ctolleson/OpenNeurostimulatorCMT/Examples/IPG PCBA/IPG-V1 BOM.xlsx

Quantity | Designator | Description | Manufacturer | Manufacturer Part Number
8 | C100, C101, C104, C105, C210, C211, C215, C219 | Ceramic Capacitor, Multilayer, Ceramic, 25V, 5% +Tol, 5% -Tol, C0G, 30ppm/Cel TC, 0.000012uF, Surface Mount, 0201 | Murata | GRM0335C1E120JA01D
15 | C102, C103, C115, C118, C119, C213, C306, C317, C319, C501, C503, C504, C600, C1201, C1203 | Capacitor, 4.7uF, X5R, 16V, 10%, 0603, Implant-grade | Murata | GRM188R61C475KE11
49 | C106, C107, C108, C109, C110, C111, C112, C113, C114, C116, C120, C214, C216, C307, C500, C502, C507, C508, C509, C510, C511, C512, C602, C700, C701, C702, C703, C704, C800, C801, C807, C808, C815, C816, C819, C820, C821, C822, C901, C903, C905, C908, C1101, C1200, C1202, C1204, C1207, C1300, C1301 | Ceramic Capacitor, Multilayer, Ceramic, 25V, 10% +Tol, 10% -Tol, X5R, 15% TC, 0.1uF, Surface Mount, 0201 | Murata | GRM033R61E104KE14J
7 | C117, C218, C400, C420, C1102, C1205, C1206 | Ceramic Capacitor, Multilayer, Ceramic, 16V, 20% +Tol, 20% -Tol, X5R, 15% TC, 1uF, Surface Mount, 0201 | Murata | GRM033R61C105ME15D
1 | C200 | Capacitor, 0.8pF, Silicon RF, 200V, Tolerance 0.05pF, 0402, Implant-grade | Kyocera AVX | 600L0R8AT200T
1 | C201 | Capacitor, 1pF, RF Capacitors, 200V, Tolerance 0.01pF, 0402, Implant-grade | Kyocera AVX | 600L1R0AT200T
1 | C217 | Ceramic Capacitor, Multilayer, Ceramic, 25V, 10% +Tol, 10% -Tol, X7R, 15% TC, 0.0001uF, Surface Mount, 0201 | Murata | GRM033R71E101KA01D
2 | C300, C301 | Capacitor, 27nF, C0G, 100VDC, 2%, 0805, Implant-grade | Murata | GRM2195C2A273GE01D
2 | C302, C303 | Capacitor, 4.7nF, C0G, 25V, 1%, 0603, Implant-grade | KEMET | C0603C472F3GECTU
1 | C304 | Ceramic Capacitor, Multilayer, Ceramic, 25V, 5% +Tol, 5% -Tol, C0G, 30ppm/Cel TC, 0.000033uF, Surface Mount, 0201 | Murata | GRM0335C1E330JA01D
5 | C310, C311, C318, C505, C506 | Capacitor, 4.7uF, X7S, 35V, 10%, 0805, Implant-grade | Murata | GCM21BC7YA475KE36L
2 | C315, C316 | Capacitor, 0.022uF, X7R, 50V, 10%, 0402, Implant-grade | Murata | GCM155R71H223KA55
2 | C417, C422 | Capacitor, 0.1uF, X7R, 16V, 10%, 0402, Implant-grade | Murata | GCM155R71C104KA55
2 | C419, C423 | Ceramic Capacitor, Multilayer, Ceramic, 25V, 10% +Tol, 10% -Tol, X7R, 15% TC, 0.00047uF, Surface Mount, 0201 | Murata | GCM033R71E471KA03D
1 | C601 | Capacitor, 10uf, X5R, 10V, 20%, 0402, Implant-grade | Murata | ZRB15XR61A106ME01D
2 | C802, C804 | Capacitor, 0.33uF, X7S, 16V, 10%, 0402 | TDK | CGA2B1X7S1C334K050BC
5 | C803, C805, C810, C814, C823 | Ceramic Capacitor, Multilayer, Ceramic, 25V, 10% +Tol, 10% -Tol, X7R, 15% TC, 0.001uF, Surface Mount, 0201 | Murata | GRM033R71E102KA01J
1 | C806 | Capacitor, 1500pF, X7R, 50V, 10%, 0402 | Murata | GCM155R71H152KA37D
2 | C809, C827 | Ceramic Capacitor, Multilayer, Ceramic, 6.3V, 20% +Tol, 20% -Tol, X5R, 15% TC, 1.5uF, Surface Mount, 0201 | Murata | GRM033R60J155ME14D
4 | C811, C812, C824, C825 | Capacitor, 470nF, X5R, 6.3V, 10%, 0201, Implant Grade | Murata | GRT033R60J474KE01D
2 | C813, C828 | 68 pF ±5% 50V Ceramic Capacitor C0G, NP0 0201 (0603 Metric) | Murata Electronics | GRM0335C1H680JA01D
2 | C817, C818 | Capacitor, 2.2uF, X7R, 16V, 10%, 0603, Implant-grade | Murata | GRM188Z71C225ME43J
2 | C826, C829 | 270 pF ±5% 25V Ceramic Capacitor C0G, NP0 0201 (0603 Metric) | Murata Electronics | GRM0335C1E271JA01D
9 | C900, C902, C904, C906, C907, C909, C910, C911, C912 | Capacitor, 10uF, X5R, 50V, 10%, 0805 | Murata | GRM21BR61H106ME43L
16 | C1000, C1001, C1002, C1003, C1004, C1005, C1006, C1007, C1008, C1009, C1010, C1011, C1012, C1013, C1014, C1015 | Capacitor, 680pF, C0G, 100V, 5%, 0402 | TDK | C1005C0G2A681J050BE
1 | C1016 | Capacitor, 68pF, C0G, 25V, 5%, 0201, Implant-grade | Murata | GRT0335C1E680JA02D
10 | D300, D301, D305, D306, D400, D420, D502, D503, D505, D506 | Schottky, 40V, 500mA, 530mV, SOD-523 | ON Semiconductor | NSR05T40XV2T5G
1 | D307 | Zener Diode 10 V 300 mW ±2% Surface Mount DFN1006-2A 0402 | Vishay | BZX884B10L-G3-08
7 | D419, D421, D422, D423, D424, D600, D601 | Schottky, 30V, 100mA, 385mV, 200mW, SOD-923 | ON Semiconductor | NSR0130P2T5G
16 | D800, D801, D802, D803, D804, D805, D806, D807, D808, D809, D810, D811, D812, D813, D814, D815 | Diode | Nexperia | BAS116LS-QYL
17 | D1000, D1001, D1002, D1003, D1004, D1005, D1006, D1007, D1008, D1009, D1010, D1011, D1012, D1013, D1014, D1015, D1016 | Diode ESD (Bi-directional) | Nexperia | PESD5V0S1BLD,315
2 | D1101, D1102 | ESD TVS DIODE 3.3VWM 6.2VC 0402C | Comchip Technology | CPDQC3V3T-HF
1 | D1201 | TVS DIODE 5.5VWM 6TSOP | Nexperia | IP4220CZ6F
1 | D1202 | LED, GREEN, SMD, 0603, 3.2V, 20mA | Lite-On Inc. | LTST-C191TGKT
1 | D1203 | LED, RED, SMD, 0603, 2V, 30mA | Lite-On Inc. | LTST-C191KRKT
1 | D1204 | LED, ORANGE, SMD, 0603, 2V, 30mA | Lite-On Inc. | LTST-C191KFKT
2 | F400, F401 | Fuse, 750mA, 63V, 1206 | Littelfuse | 0440.750WR
4 | J100, J102, J201, J202 | 0.025" SQ Post Header, Through-hole, Vertical, -55 to 125 degC, 2.54 mm Pitch, 6-Pin, Male, RoHS | Samtec | TSW-106-07-G-S
2 | J101, J200 | Connector, 1.27 mm, 2x5, Male, TH | Samtec | FTSH-105-01-F-D-K
1 | J203 | RF Connector, 1 Contact(s), Male, Board Mount, Surface Mount Terminal, Receptacle | Hirose | U.FL-R-SMT-1(10)
5 | J302, J421, J424, J1101, J1202 | Board Connector, 4 Contact(s), 1 Row(s), Male, Straight, 0.1 inch Pitch, Solder Terminal, Black Insulator, Receptacle | Samtec | TSW-104-07-G-S
17 | J1017, J1018, J1019, J1020, J1021, J1022, J1023, J1024, J1025, J1026, J1027, J1028, J1029, J1030, J1031, J1032, J1033 | Connector, Bannana Tip, Through Hole, Rodent Study lead connector | Cinch Connectivity Solutions Johnson | 105-0753-001
1 | J1201 | CONN RCP USB3.1 TYPEC 24P SMD RA | Molex | 1054500101
1 | L100 | Inductor, 2.2uH, 1.76A, 1008 | TDK | VLS252010HBX-2R2M-1
1 | L101 | Inductor, Unshielded, 33nH, 350mA, 0402 | Murata | LQG15HS33NJ02D
1 | L200 | Inductor, 3.9nH, 1.95A, 2%, 0402 | Murata | LQW15AN3N9G80D
1 | L201 | Inductor, 1.8nH, 0.46A, Tolerance 0.2 nH, 0402 | Murata | LQW15AN1N8C00D
2 | L300, L500 | Inductor, 10uH, 600mA, 20%, 1008 | Wurth | 74438323100
3 | M200, M314, M700 | MOSFET, P-chan, -20V, -383mA, DFN0604 | Diodes Inc | DMP22D4UFO-7B
4 | M300, M311, M312, M504 | MOSFET, N-Chan, 60V, 320mA, DFN1006 | Diodes Inc | DMN62D1LFB-7B
4 | M305, M308, M309, M501 | MOSFET, P-chan, -65V, -290mA, DFN1006 | Diodes Inc | DMP68D1LFB
5 | M306, M401, M402, M410, M411 | MOSFET, P-chan, -20V, -3.4A, DFN1010-3 | Diodes Inc | DMP2043UCA3-7
1 | M310 | MOSFET, N-Chan, 60V, 300mA, DFN1006 | Diodes Inc | DMN62D1SFB-7B
11 | M400, M405, M409, M412, M420, M421, M500, M505, M600, M601, M603 | MOSFET, P-chan, -20V, -400mA, X2-DFN1006-3 | Diodes Inc | DMP21D5UFB4-7B
26 | M403, M404, M406, M407, M408, M413, M414, M415, M416, M417, M418, M419, M422, M502, M503, M506, M602, M604, M701, M1300, M1302, M1305, M1306, Q1101, Q1102, Q1103 | MOSFET, N-Chan, 20V, 170mA, DFN0606 | Diodes Inc | DMN2990UFZ-7B
9 | M900, M901, M902, M903, M904, M905, M906, M907, M908 | MOSFET, N-Chan, 60V, 210mA, DFN1006 | Diodes Inc | DMN65D8LFB-7B
9 | Q900, Q902, Q904, Q906, Q907, Q911, Q913, Q915, Q917 | TRANS 2PNP 40V 0.2A SOT963 | ON Semi | NST3906DP6T5G
10 | Q901, Q903, Q905, Q908, Q909, Q910, Q912, Q914, Q916, Q918 | Transistor, NPN, 45V, 100mA, DFN1006 | Diodes Inc | BC847BLP-7B
8 | R100, R101, R404, R415, R510, R908, R1101, R1103 | Fixed Resistor, Metal Glaze/thick Film, 0.05W, 10000ohm, 30V, 1% +/-Tol, 200ppm/Cel, Surface Mount, 0201 | Vishay | CRCW020110K0FNED
13 | R102, R103, R359, R429, R430, R702, R708, R806, R821, R835, R857, R912, R1106 | Fixed Resistor, Metal Glaze/thick Film, 0.05W, 0ohm, Surface Mount, 0201 | Vishay | CRCW02010000Z0ED
30 | R310, R316, R317, R318, R320, R322, R324, R325, R328, R329, R330, R402, R403, R412, R414, R421, R422, R423, R424, R425, R426, R427, R428, R812, R813, R814, R845, R929, R931, R1208 | Fixed Resistor, Metal Glaze/thick Film, 0.05W, 1000000ohm, 30V, 1% +/-Tol, 200ppm/Cel, Surface Mount, 0201 | Vishay | CRCW02011M00FNED
1 | R315 | Fixed Resistor, Metal Glaze/thick Film, 0.05W, 402ohm, 30V, 1% +/-Tol, 200ppm/Cel, Surface Mount, 0201 | Vishay | CRCW0201402RFNED
1 | R319 | Fixed Resistor, Metal Glaze/thick Film, 0.05W, 49.9ohm, 30V, 1% +/-Tol, 200ppm/Cel, Surface Mount, 0201 | Vishay | CRCW020149R9FNED
3 | R323, R838, R861 | Fixed Resistor, Metal Glaze/thick Film, 0.05W, 150000ohm, 30V, 1% +/-Tol, 200ppm/Cel, Surface Mount, 0201 | Vishay | CRCW0201150KFNED
5 | R326, R500, R705, R829, R856 | Fixed Resistor, Metal Glaze/thick Film, 0.05W, 100000ohm, 30V, 1% +/-Tol, 200ppm/Cel, Surface Mount, 0201 | Vishay | CRCW0201100KFNED
51 | R336, R341, R400, R401, R408, R410, R411, R413, R502, R503, R504, R505, R509, R600, R601, R602, R603, R604, R703, R800, R801, R803, R804, R808, R809, R815, R819, R823, R824, R832, R833, R834, R836, R837, R846, R847, R848, R849, R903, R910, R916, R924, R925, R935, R940, R945, R950, R1300, R1302, R1304, R1306 | Fixed Resistor, Metal Glaze/thick Film, 0.05W, 10000000ohm, 30V, 1% +/-Tol, 200ppm/Cel, Surface Mount, 0201 | Vishay Draloric | CRCW020110M0FNED
3 | R337, R348, R356 | Fixed Resistor, Metal Glaze/thick Film, 0.05W, 49900ohm, 30V, 1% +/-Tol, 200ppm/Cel, Surface Mount, 0201 | Vishay | CRCW020149K9FNED
2 | R405, R416 | Fixed Resistor, Metal Glaze/thick Film, 0.05W, 4020ohm, 30V, 1% +/-Tol, 200ppm/Cel, Surface Mount, 0201 | Vishay | CRCW02014K02FNED
2 | R406, R417 | Fixed Resistor, Metal Glaze/thick Film, 0.05W, 7500ohm, 30V, 1% +/-Tol, 200ppm/Cel, Surface Mount, 0201 | Vishay | CRCW02017K50FNED
2 | R407, R419 | Resistor, 619k, 0.1%, 0402 | Vishay | MCS0402MD6193BE000
2 | R409, R420 | Resistor, 243k, 0.1%, 0402 | TE Connectivity | RP73PF1E243KBTDF
1 | R418 | Fixed Resistor, Metal Glaze/thick Film, 0.05W, 5100000ohm, 30V, 1% +/-Tol, 200ppm/Cel, Surface Mount, 0201 | Vishay Draloric | CRCW02015M10FNED
2 | R501, R928 | Fixed Resistor, Metal Glaze/thick Film, 0.05W, 100ohm, 30V, 1% +/-Tol, 200ppm/Cel, Surface Mount, 0201 | Vishay | CRCW0201100RFNED
1 | R506 | Fixed Resistor, Metal Glaze/thick Film, 0.05W, 340000ohm, 30V, 1% +/-Tol, 200ppm/Cel, Surface Mount, 0201 | Vishay | CRCW0201340KFKED
1 | R511 | Fixed Resistor, Metal Glaze/thick Film, 0.05W, 40200ohm, 30V, 1% +/-Tol, 200ppm/Cel, Surface Mount, 0201 | Vishay | CRCW020140K2FNED
2 | R700, R706 | Fixed Resistor, Metal Glaze/thick Film, 0.05W, 8200ohm, 30V, 1% +/-Tol, 200ppm/Cel, Surface Mount, 0201 | Vishay | CRCW02018K20FNED
2 | R701, R707 | Fixed Resistor, Metal Glaze/thick Film, 0.05W, 59000ohm, 30V, 1% +/-Tol, 200ppm/Cel, Surface Mount, 0201 | Vishay | CRCW020159K0FNED
1 | R704 | Fixed Resistor, Metal Glaze/thick Film, 0.05W, 120000ohm, 30V, 1% +/-Tol, 200ppm/Cel, Surface Mount, 0201 | Vishay Dale | CRCW0201120KFNED
1 | R802 | Fixed Resistor, Metal Glaze/thick Film, 0.05W, 1400000ohm, 30V, 1% +/-Tol, 200ppm/Cel, Surface Mount, 0201 | Vishay Draloric | CRCW02011M40FNED
8 | R805, R807, R820, R822, R839, R840, R850, R851 | Fixed Resistor, Metal Glaze/thick Film, 0.05W, 180000ohm, 30V, 1% +/-Tol, 200ppm/Cel, Surface Mount, 0201 | Vishay | CRCW0201180KFNED
4 | R810, R825, R841, R852 | Fixed Resistor, Metal Glaze/thick Film, 0.05W, 360000ohm, 30V, 1% +/-Tol, 200ppm/Cel, Surface Mount, 0201 | Vishay | CRCW0201360KFNED
1 | R811 | Fixed Resistor, Metal Glaze/thick Film, 0.05W, 2200000ohm, 30V, 1% +/-Tol, 200ppm/Cel, Surface Mount, 0201 | Vishay Draloric | CRCW02012M20FNED
2 | R816, R858 | Fixed Resistor, Metal Glaze/thick Film, 0.05W, 200000ohm, 30V, 1% +/-Tol, 200ppm/Cel, Surface Mount, 0201 | Vishay | CRCW0201200KFNED
4 | R817, R826, R853, R854 | 3.32 MOhms ±1% 0.05W, 1/20W Chip Resistor 0201 (0603 Metric) Thick Film | Vishay Dale | CRCW02013M32FNED
2 | R818, R855 | 475 kOhms ±1% 0.05W, 1/20W Chip Resistor 0201 (0603 Metric) Thick Film | Vishay Dale | CRCW0201475KFNED
2 | R827, R859 | 1.2 MOhms ±1% 0.05W, 1/20W Chip Resistor 0201 (0603 Metric) Thick Film | Vishay Dale | CRCW02011M20FNED
2 | R828, R860 | 3.74 kOhms ±1% 0.05W, 1/20W Chip Resistor 0201 (0603 Metric) Thick Film | Vishay Dale | CRCW02013K74FNED
2 | R830, R831 | Fixed Resistor, Metal Glaze/thick Film, 0.05W, 6800000ohm, 30V, 1% +/-Tol, 200ppm/Cel, Surface Mount, 0201 | Vishay Draloric | CRCW02016M80FNED
2 | R842, R843 | Fixed Resistor, Metal Glaze/thick Film, 0.05W, 2700000ohm, 30V, 1% +/-Tol, 200ppm/Cel, Surface Mount, 0201 | Vishay Draloric | CRCW02012M70FNED
1 | R844 | Fixed Resistor, Metal Glaze/thick Film, 0.05W, 249000ohm, 30V, 1% +/-Tol, 200ppm/Cel, Surface Mount, 0201 | Vishay | CRCW0201249KFNED
14 | R901, R906, R914, R919, R922, R933, R938, R943, R948, R1200, R1203, R1204, R1206, R1207 | Fixed Resistor, Metal Glaze/thick Film, 0.05W, 1000ohm, 30V, 1% +/-Tol, 200ppm/Cel, Surface Mount, 0201 | Vishay | CRCW02011K00FNED
9 | R902, R907, R915, R920, R923, R934, R939, R944, R949 | Fixed Resistor, Metal Glaze/thick Film, 0.05W, 150ohm, 30V, 1% +/-Tol, 200ppm/Cel, Surface Mount, 0201 | Vishay | CRCW0201150RFNED
9 | R904, R911, R917, R926, R927, R936, R941, R946, R951 | Fixed Resistor, Metal Glaze/thick Film, 0.05W, 2000000ohm, 30V, 1% +/-Tol, 200ppm/Cel, Surface Mount, 0201 | Vishay Draloric | CRCW02012M00FNED
1 | R930 | Fixed Resistor, Metal Glaze/thick Film, 0.05W, 2800ohm, 30V, 1% +/-Tol, 200ppm/Cel, Surface Mount, 0201 | Vishay | CRCW02012K80FNED
3 | R1102, R1104, R1105 | Fixed Resistor, Metal Glaze/thick Film, 0.05W, 6800ohm, 30V, 1% +/-Tol, 200ppm/Cel, Surface Mount, 0201 | Vishay | CRCW02016K80FNED
2 | R1201, R1202 | Fixed Resistor, Metal Glaze/thick Film, 0.05W, 5110ohm, 30V, 1% +/-Tol, 200ppm/Cel, Surface Mount, 0201 | Vishay | CRCW02015K11FNED
3 | R1205, R1210, R1211 | Resistor 200 1%, 0402, Non Implant-grade | Vishay | CRCW0402200RFKEDHP
2 | R1301, R1303 | Fixed Resistor, Metal Glaze/thick Film, 0.2W, 499ohm, 50V, 1% +/-Tol, 100ppm/Cel, Surface Mount, 0402 | Vishay Dale | CRCW0402499RFKEDHP
1 | SW500 | Pushbutton, NO-MOM, 12V, 0.05A, SMT | C&K | PTS647SN50SMTR2LFS
1 | U100 | FRAM, 8 Mbit (1024k x 8), SPI, 1.8-3.6V, QFN-8 | Cypress Semiconductor | CY15B108QN-20LPXC
1 | U101 | Microcontroller, ARM Cortex-M33, 2.0 MB Flash, 786 kB RAM, BGA-132 pins with dedicated pinout supporting SMPS step-down converter | STMicro | STM32U585QII6Q
1 | U200 | Bluetooth radio, v5.0, 192 kB Flash, 24 kB RAM, BGA-33 | Nordic | NRF52810-CAAA-E-R7
6 | U300, U302, U313, U314, U404, U405 | Op Amp, Rail-to-Rail, 95kHz, WLCSP-6 | Analog Devices | AD8505ACBZ-R7
1 | U315 | Buck-Boost Converter, Selectable Voltage, QFN-20 | Analog Devices | LTC3130IUDC-1#PBF
2 | U400, U402 | Charge Controller, 4.2V, 250mA, DFN-6 | Linear Technology | LTC4065LEDC#TRPBF
2 | U401, U403 | Comparator, 1.2V Reference, Open-drain, BGA-4 | Texas Instruments | TLV4021R1YKAR
3 | U500, U502, U504 | LDO Regulator, 3.3V, Shutdown, DFN1010-4 | Diodes Inc | AP7354D-33FS4-7
1 | U501 | Boost, SEPIC Switching Regulator IC Positive Adjustable 1.23V 1 Output 75mA (Switch) SOT-23-5 | Linear Technology | LT1615ES5-1#TRPBF
1 | U503 | Digital potentiometer, 256 taps, 100k, I2C, QFN-10 | Renesas | ISL23315TFRUZ-T7A
1 | U505 | Reset Monitor, 2.63V, Active low, X2SON | Texas Instruments | TPS3831L30DQNR
1 | U600 | Magnet Sensor, 15 Gauss, ULLGA4, Implant-grade | NVE | ADL021-14E
2 | U700, U701 | Multiplexer, 8:1, 0.7 ohms, QFN-16 | Maxim | MAX4781ETE+T
2 | U702, U905 | Op Amp, Dual, Rail-to-Rail, 1MHz, BGA-9 | Texas Instruments | TLV9002SIYCKR
1 | U703 | Differential Amplifier, 110 MHz, DFN-8 | Analog Devices | AD8137YCPZ-REEL7
1 | U704 | SPDT, 2 Func, 1 Channel, CMOS | Analog Devices | ADG772BCPZ-REEL7
2 | U800, U802 | Analog front end, ECG, RLD amp, BGA-20 | Analog Devices | AD8233ACBZ-R7
2 | U801, U803 | Analog Circuit, 1 Func, 1 Channel | Analog Devices | AD8232ACPZ-R7
1 | U900 | Monostable, RC set, dual triggers, BGA-8 | Texas Instruments | SN74LVC1G123YZPR
1 | U901 | AND gate, Dual 2-input, BGA-8 | Texas Instruments | SN74LVC2G08YZPR
1 | U902 | DAC, 16-bit, Dual channel, SPI/I2C, WSON-10 | Texas Instruments | DAC80502DRXT
3 | U903, U904, U1101 | Analog Switch, SPDT, 2:1, DSBGA6 | Texas Instruments | TS5A3159AYZPR
1 | U1201 | IC USB TO UART BRIDGE QFN20 | Silicon Labs | CP2102N-A02-GQFN20R
2 | U1202, U1203 | Fixed Positive LDO Regulator, 3.7V, 0.375V Dropout, PDSO6 | Texas Instruments | TLV70237DSET
2 | U1301, U1302 | IC SWITCH SPDTX4 4.5OHM 20LFCSP | Analog Devices | ADG1634BCPZ-REEL7
1 | Y100 | 48 MHz Â±10ppm Crystal 10pF 100 Ohms 4-SMD, No Lead | ECS Inc. | ECS-480-10-48-CKY-TR
2 | Y101, Y201 | CRYSTAL 32.7680KHZ 6PF SMD | Micro Crystal | CM8V-T1A-32.768KHZ-6PF-20PPM-TA-QC
1 | Y200 | 32 MHz Â±10ppm Crystal 10pF 100 Ohms 4-SMD, No Lead | ECS Inc. | ECS-320-10-48-CKY-TR
