ctolleson/OpenNeurostimulatorCMT/Examples/IPG PCBA/IPG-V1 assembly.PDF

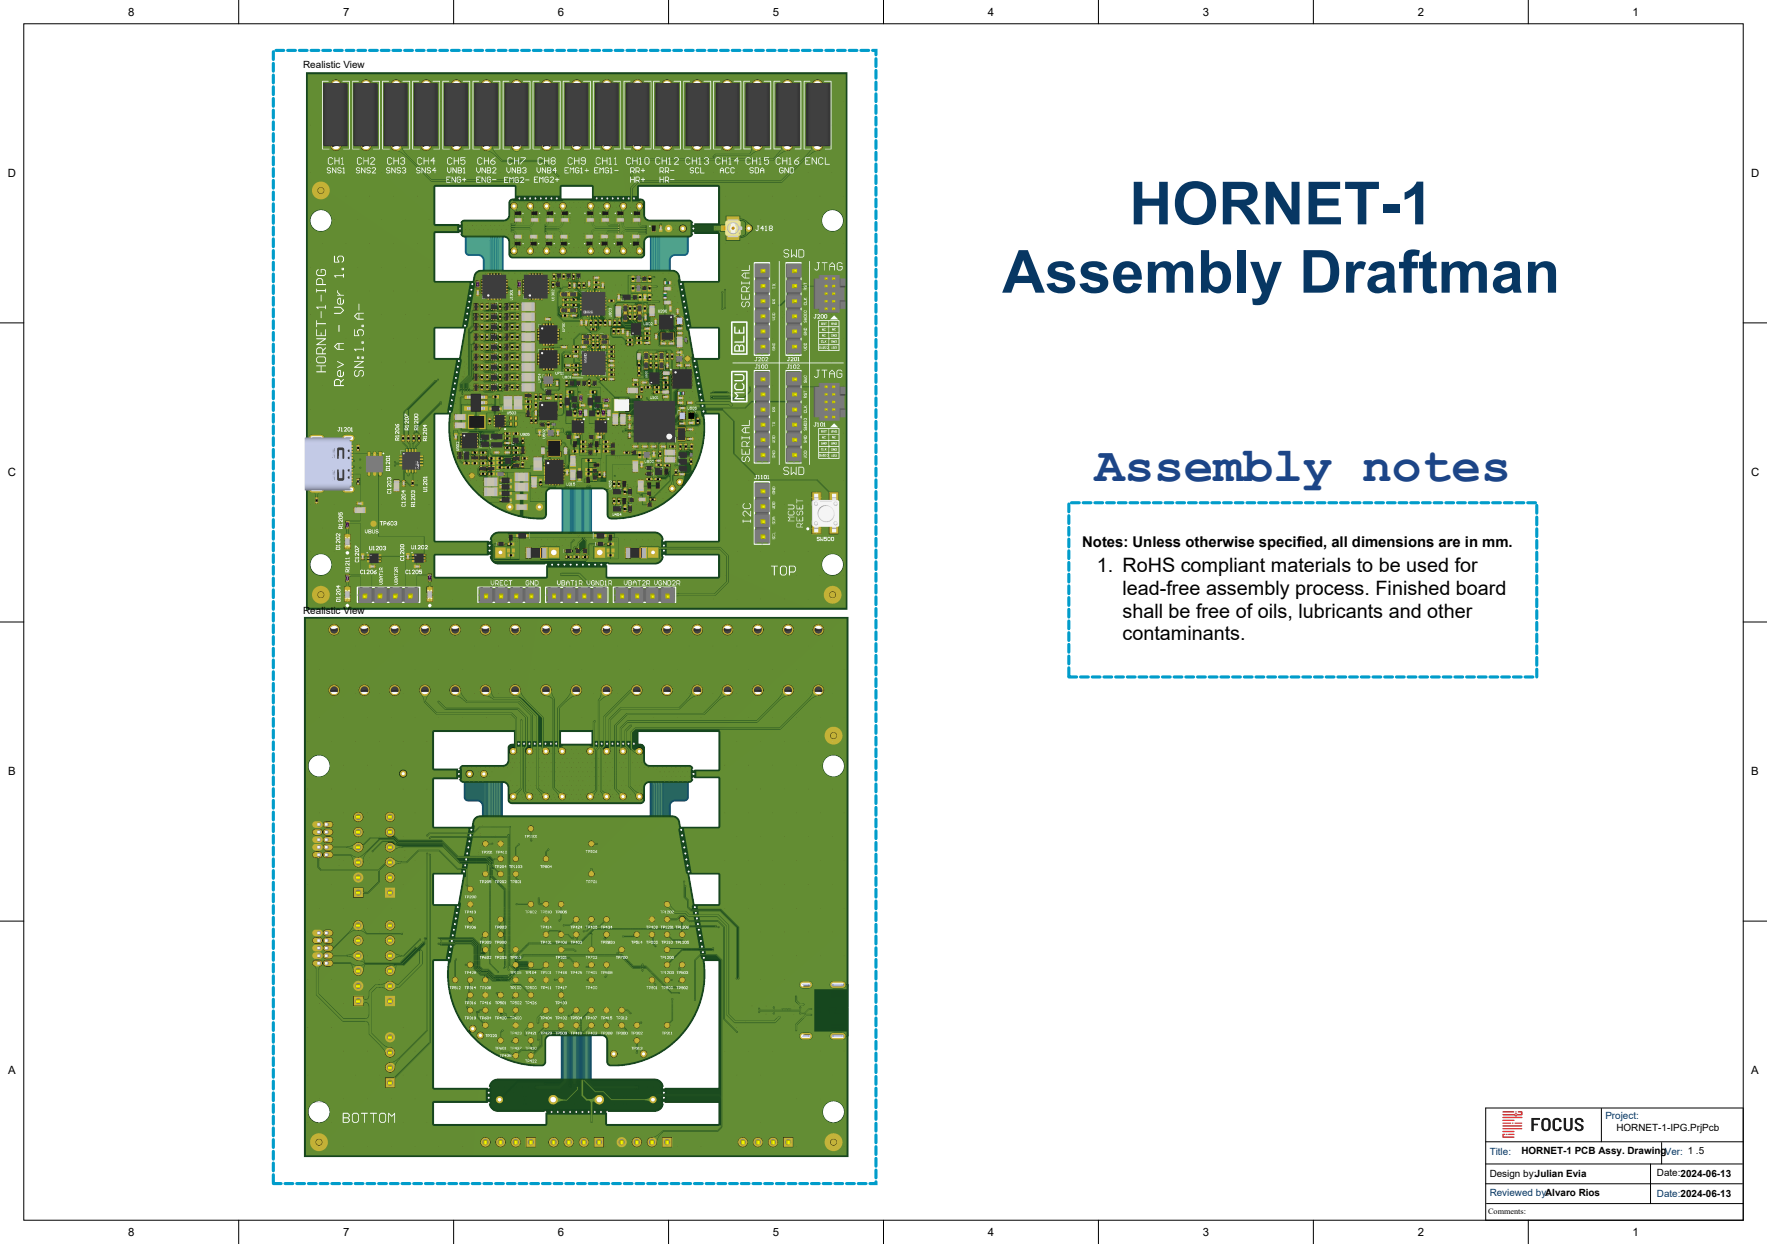
[picture p1: page 1]

Notes: Unless otherwise specified, all dimensions are in mm.
RoHS compliant materials to be used for
lead-free assembly process. Finished board
shall be free of oils, lubricants and other
contaminants.

Project: HORNET-1-IPG.PrjPcb

Title: HORNET-1 PCB Assy. Drawing | Ver: 1

Design by: Julian Evia | Date: 2024-06-13
Reviewed by: Alvaro Rios | 2024-06-13

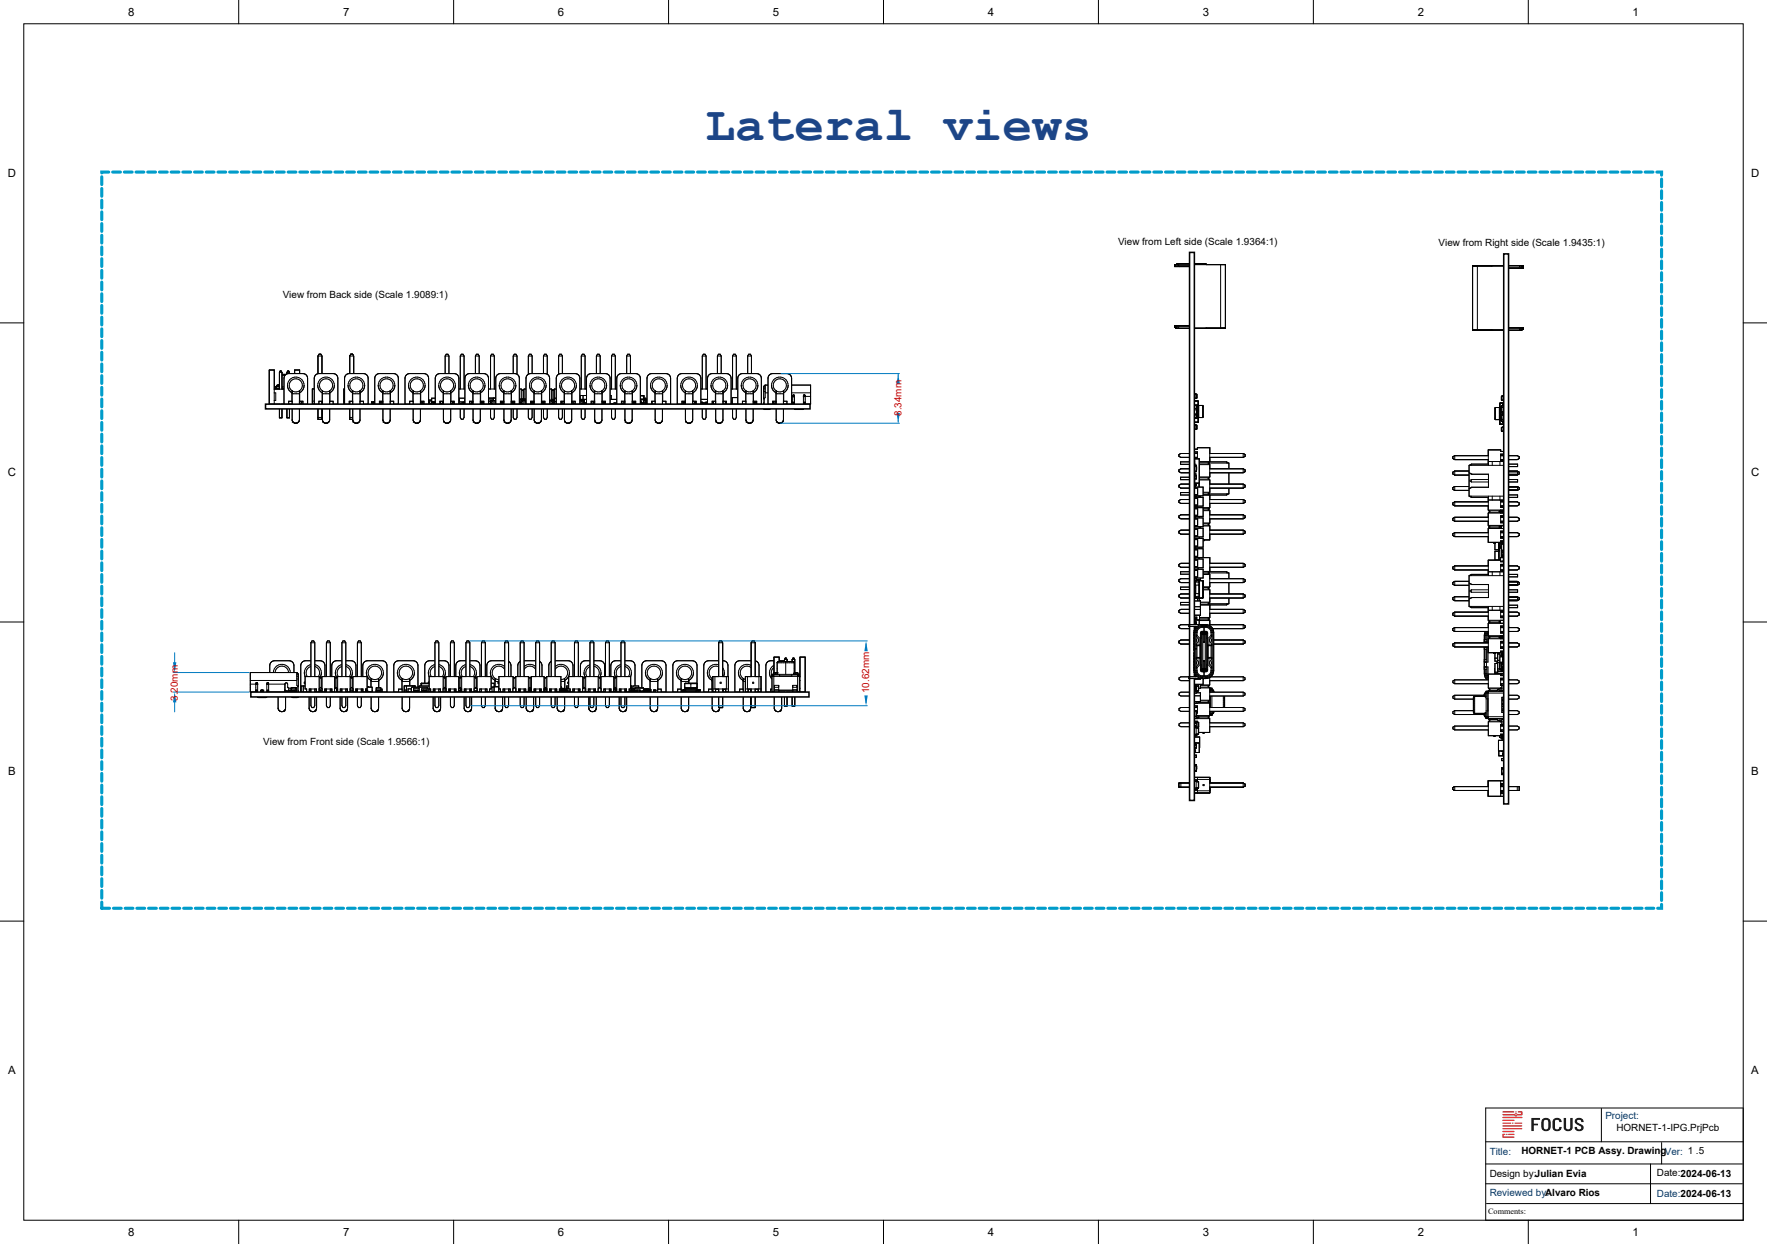
[picture p2: page 2]

View from Back side (Scale 1.9089:1)

View from Front side (Scale 1.9566:1)

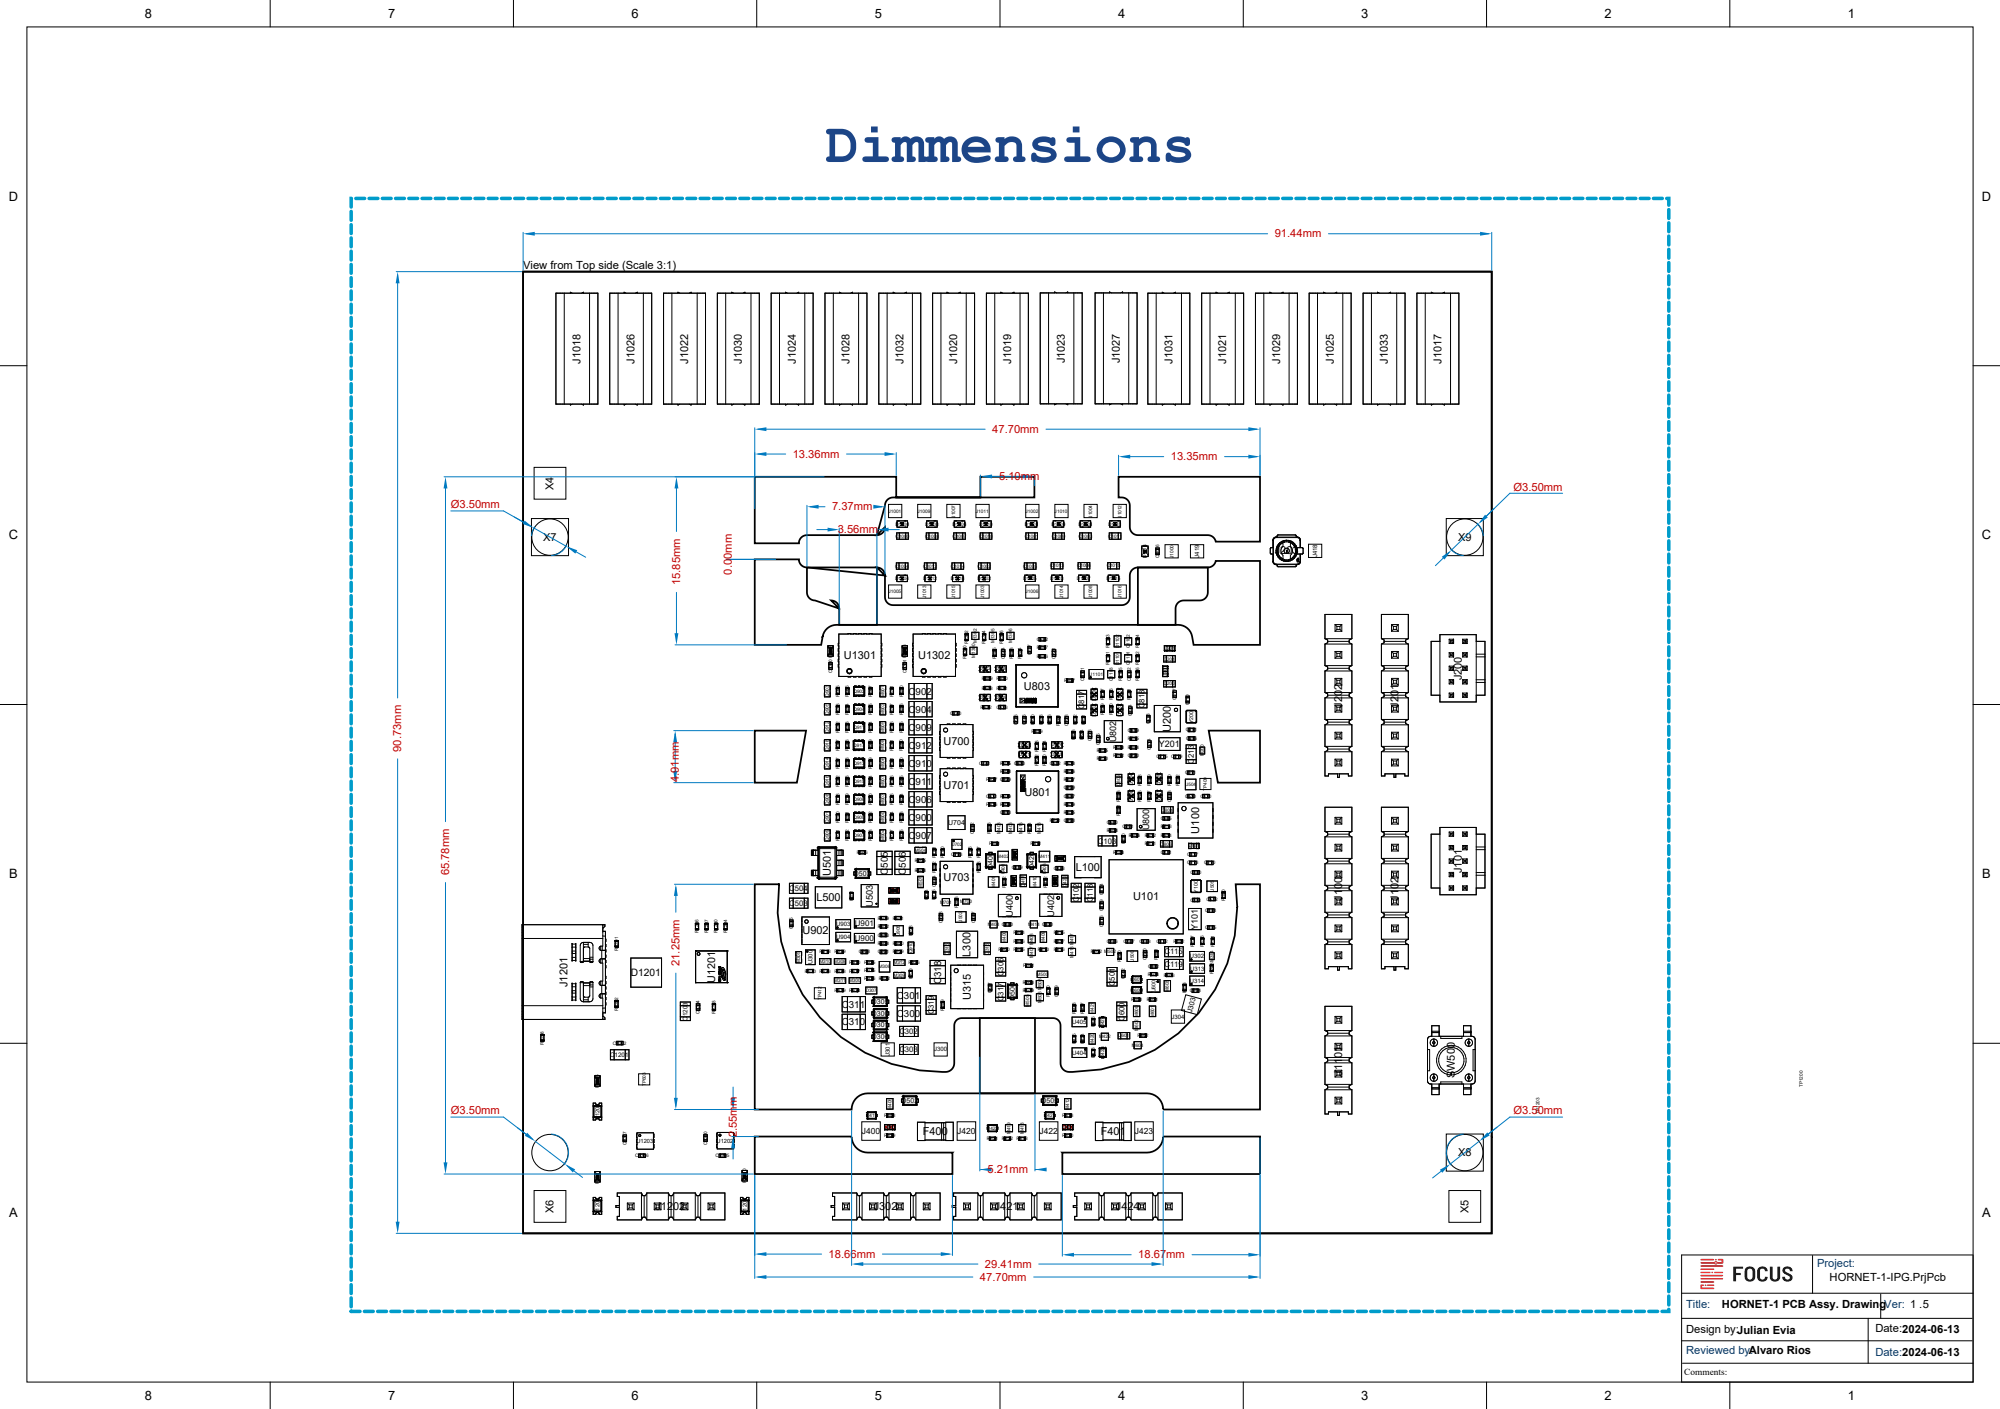
[picture p3: page 3]

View from Top side (Scale 3:1)

HORNET-1 PCB Assy. Drawing

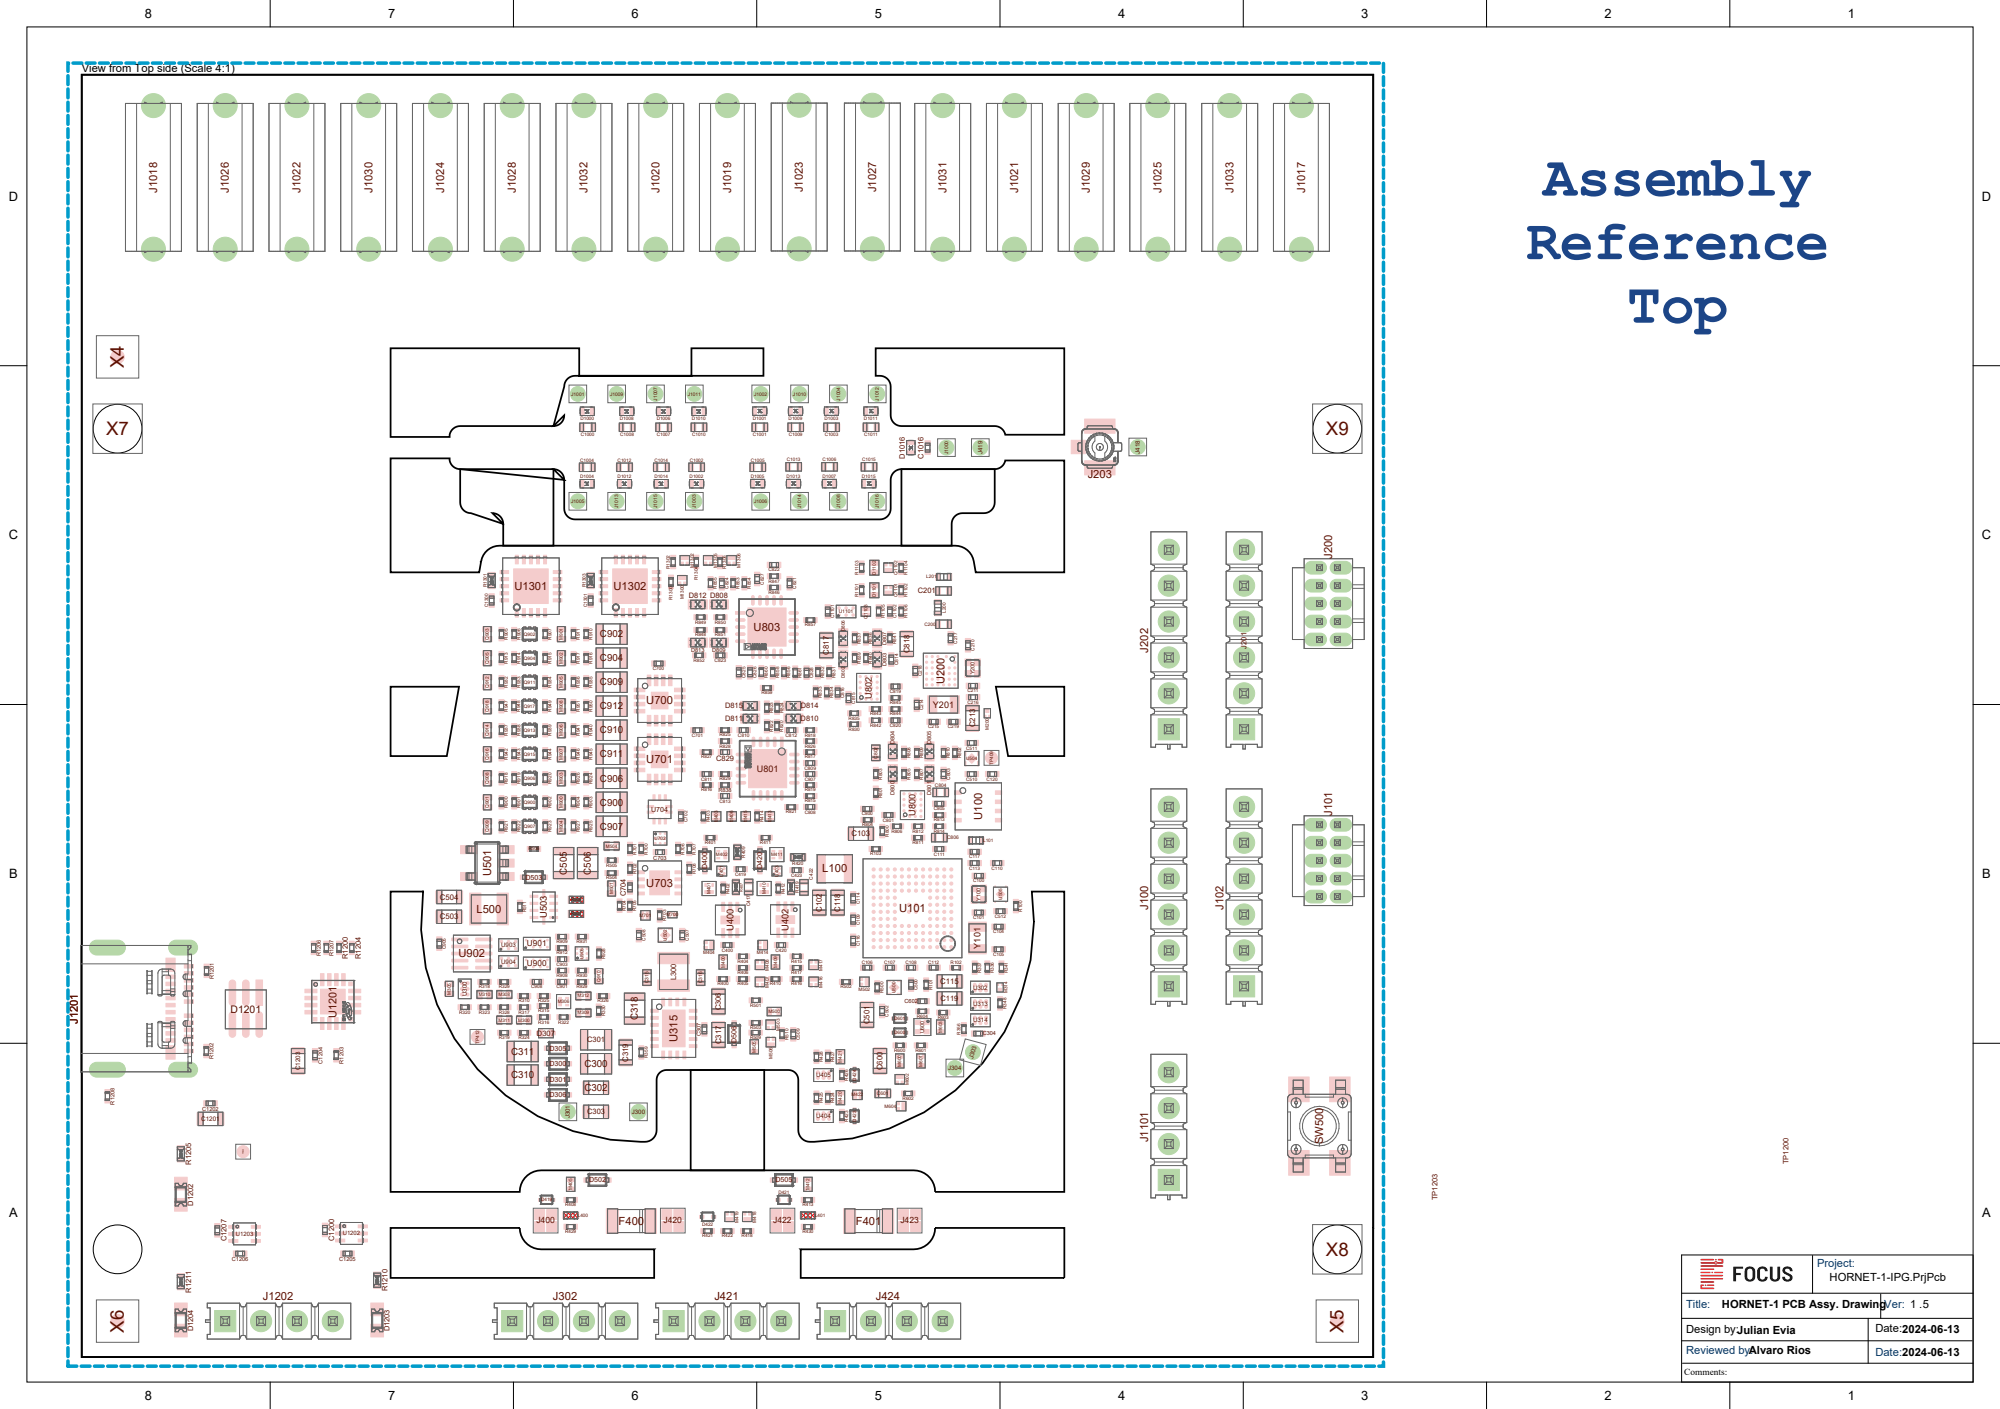
[picture p4: page 4]

View from Top side (Scale 4:1)

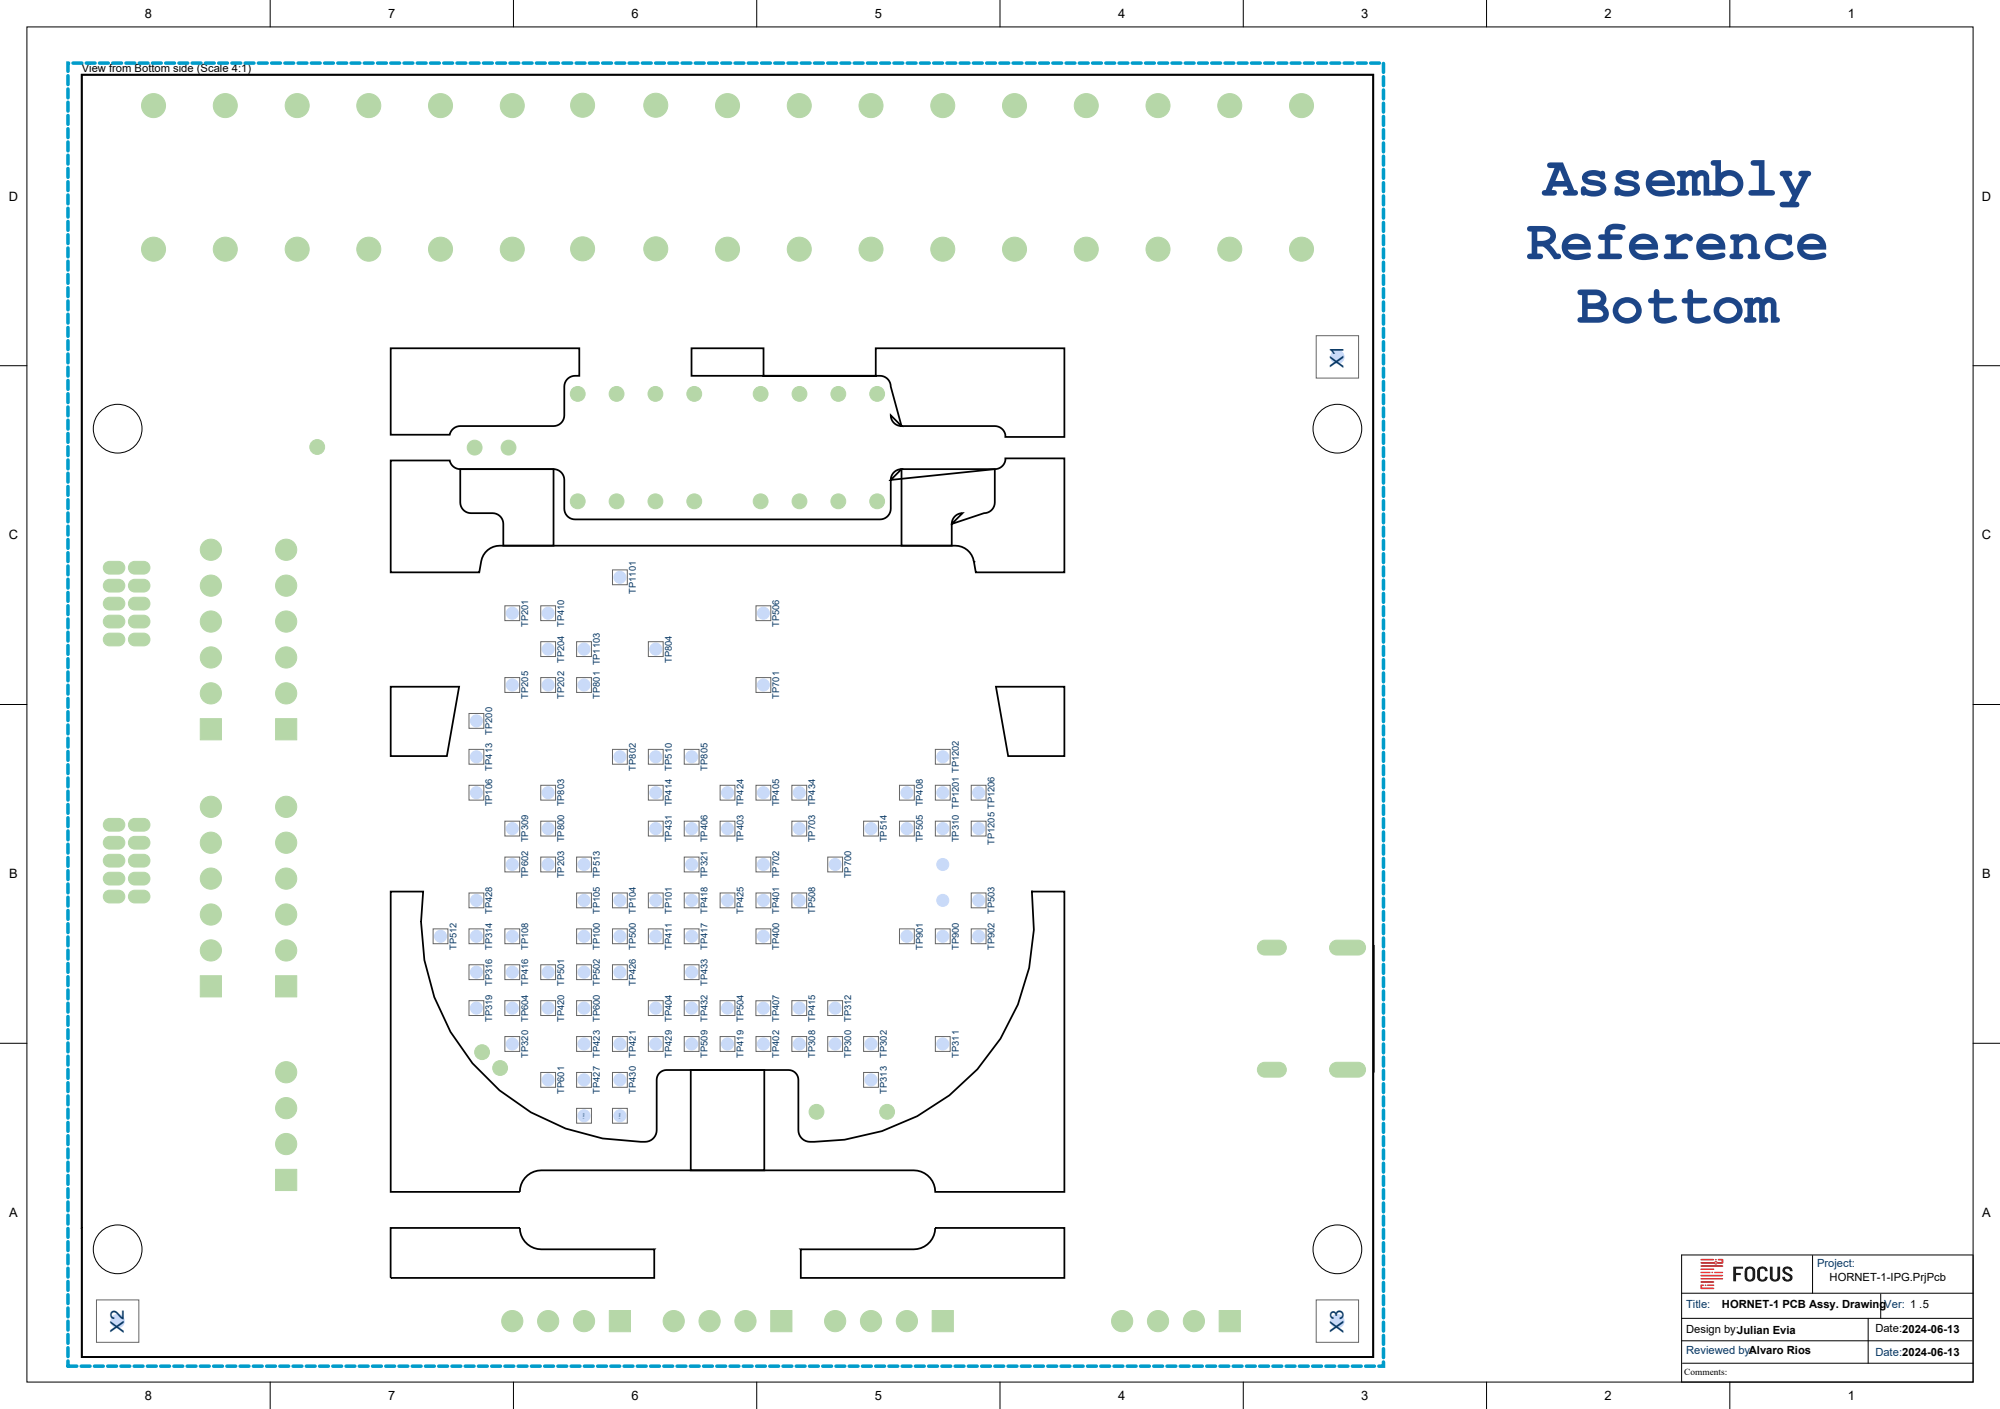
[picture p5: page 5]

View from Bottom side (Scale 4:1)
