ctolleson/OpenNeurostimulatorCMT/(list of files, drawings)

Other design files:
Examples/IPG PCBA/Archived/IPG-V1_rev0.24.PcbDoc
Examples/IPG PCBA/Archived/IPG-V1_rev0.24.SchDoc
Examples/IPG PCBA/Source Files (Altium)/Layout/HORNET-1-IPG.PrjPcb
Examples/IPG PCBA/Source Files (Altium)/Schematics/01-Cover.SchDoc
Examples/IPG PCBA/Source Files (Altium)/Schematics/02-System.SchDoc
Examples/IPG PCBA/Source Files (Altium)/Schematics/03-MCU.SchDoc
Examples/IPG PCBA/Source Files (Altium)/Schematics/04-BLE.SchDoc
Examples/IPG PCBA/Source Files (Altium)/Schematics/05-WPT.SchDoc
Examples/IPG PCBA/Source Files (Altium)/Schematics/06-BatteryManagement.SchDoc
Examples/IPG PCBA/Source Files (Altium)/Schematics/07-PowerManagement.SchDoc
Examples/IPG PCBA/Source Files (Altium)/Schematics/08-MagnetSensor.SchDoc
Examples/IPG PCBA/Source Files (Altium)/Schematics/09-IMC.SchDoc
Examples/IPG PCBA/Source Files (Altium)/Schematics/10-Sensing.SchDoc
Examples/IPG PCBA/Source Files (Altium)/Schematics/11-Stimulation.SchDoc
Examples/IPG PCBA/Source Files (Altium)/Schematics/12-Electrodes.SchDoc
Examples/IPG PCBA/Source Files (Altium)/Schematics/13-Digital.SchDoc
Examples/IPG PCBA/Source Files (Altium)/Schematics/14-TestFixture.SchDoc
Examples/IPG PCBA/Source Files (Altium)/Schematics/15-OutputMultiplexing.SchDoc
nrf7002StartingPoint/nrf7002_qfaa.PcbDoc
nrf7002StartingPoint/nrf7002_qfaa.PrjPCB
nrf7002StartingPoint/nrf7002_qfaa.SchDoc
